dplyonz/Team-10-Tensiometer-Project/README.md

# Team 10 Tensiometer Project
 ECE442 Design Project

## Repository Contents
- **Item 1:** Presentation Resources (PowerPoint slides & Poster)
- **Item 2:** Reports for Logical/Physical Design and Experimental Results
- **Item 3:** Source Code for our system

## System Parts 
- **Part 1:** US-100 Ultrasonic Range Sensor, $7, (https://www.digikey.com/en/products/detail/adafruit-industries-llc/4019/9808308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)
- **Part 2:** Capacity Hand Winch, $25, (https://www.amazon.com/dp/B082FK95GZ?psc=1&ref=ppx_pop_dt_b_asin_title)
- **Part 3:** I2C 1602 LCD Display Module, $10, (https://www.amazon.com/dp/B07S7PJYM6?psc=1&ref=ppx_yo2ov_dt_b_product_details)

## Software Dependencies
- **Dependency 1:** HX711 Arduino Library (https://github.com/bogde/HX711)
- **Dependency 2:** LiquidCrystal_I2C Library (https://github.com/fdebrabander/Arduino-LiquidCrystal-I2C-library)
